tengigabytes/CANdwich/CAD/CANdwich - Enclosure.step

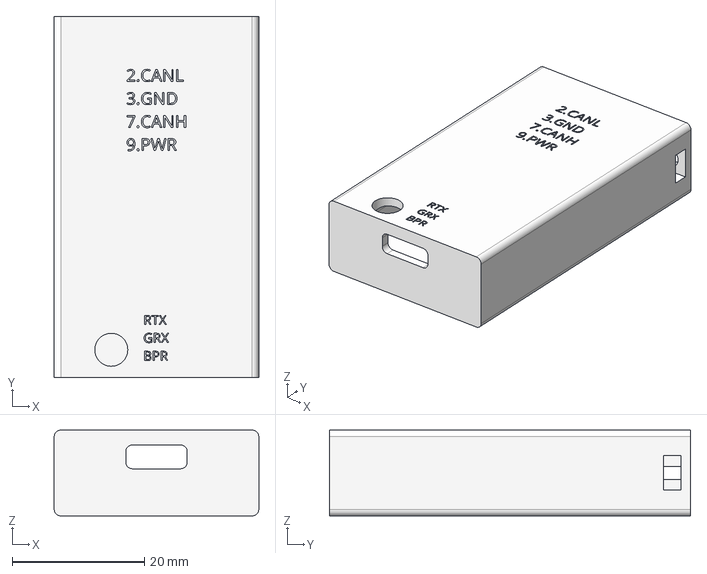
[picture p1: CAD file, 2023-06-18]
CAD/CANdwich - Enclosure.step
31.0 x 54.7 x 13.0 mm
