tengigabytes/CANdwich/CANdwich.kicad_pcb

## KiCad design CANdwich.kicad_pcb (2023-06-24)

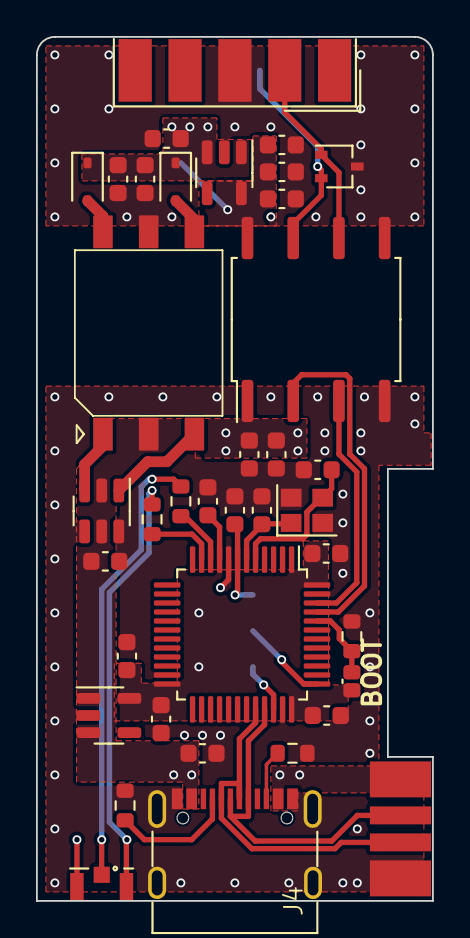
[picture p3: board CANdwich.kicad_pcb from above]

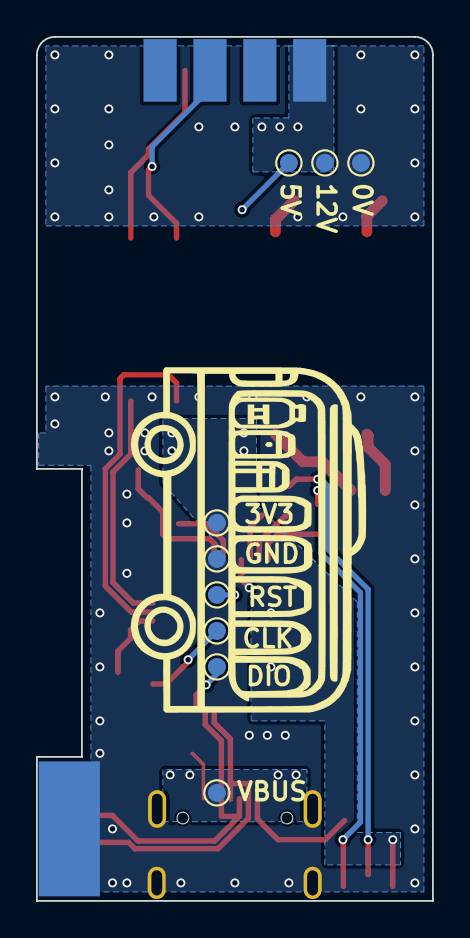
[picture p4: board CANdwich.kicad_pcb from below]

Board: 2 copper layers, 22.0 x 48.0 mm, 47 parts (9 on the bottom side), 28 nets.

Parts:
C1, C2: 8p; C_0603_1608Metric
C3, C4, C5, C6, C7, C20, C24, C25: 100n; C_0603_1608Metric
C8, C9, C22, C23, C26, C27: 1u; C_0603_1608Metric
C18, C19: 10u; C_0603_1608Metric
D1: LTST-S326KGJRKT_RG; LED_LiteOn_LTST-S326
D3, D4: NSR1020MW2T1G; D_SOD-323
D5: PESD1CAN-U; SOT-323_SC-70
J1: DE9_Receptacle; DSUB-9_Male_EdgeMount_P2.77mm
J2: USB_C_Receptacle_USB2.0; USB_C_Receptacle_XKB_U262-16XN-4BVC11
J4: Conn_01x04_Socket; USB_EdgeMount
R1: 10k; R_0603_1608Metric
R2, R3: 5.1k; R_0603_1608Metric
R4, R5, R7: 150; R_0603_1608Metric
TP1, TP2, TP3, TP4, TP5, TP6, TP7, TP8, TP9: TestPoint; TestPoint_Pad_D1.0mm
TR1: Wuerth_750316819; Transformer_Wuerth_750315371
U1: AP2127K-3.3; SOT-23-5
U2: STM32F072CBT6; LQFP-48_7x7mm_P0.5mm
U3: SN6505BDBV; SOT-23-6
U4: AP2204K-5.0TRG1; SOT-23-5
U6: ISO1050DUB; SOP-8_6.62x9.15mm_P2.54mm
Y1: 16MHz; Crystal_SMD_2520-4Pin_2.5x2.0mm

Connections:
+5VD: C23.2, C24.1, C26.2, TP4.1, U4.5 (VOUT), U6.8 (VCC2)
+12V: C19.1, C20.1, C22.2, D3.1 (K), D4.1 (K), J1.9, TP3.1, U4.1 (VIN), U4.3 (EN)
/BOOT0: R1.2, R7.1, U2.44 (BOOT0)
/CANH: D5.2 (C2), J1.7, U6.7 (CANH)
/CANL: D5.1 (C1), J1.2, U6.6 (CANL)
/CAN_RX: U2.45 (PB8), U6.2 (RXD)
/CAN_TX: U2.46 (PB9), U6.3 (TXD)
/LED_RX: R5.1, U2.11 (PA1)
/LED_TX: R4.1, U2.10 (PA0)
/SWCLK: TP6.1, U2.37 (PA14)
/SWDIO: TP5.1, U2.34 (PA13)
/USB_D+: J2.A6 (D+), J2.B6 (D+), J4.3, U2.33 (PA12)
/USB_D-: J2.A7 (D-), J2.B7 (D-), J4.2, U2.32 (PA11)
/clk_N: C2.2, U2.6 (PF1), Y1.1
/clk_P: C1.2, U2.5 (PF0), Y1.3
/nRST: C3.1, TP7.1, U2.7 (NRST)
Earth: C1.1, C2.1, C3.2, C4.1, C5.1, C6.1, C7.1, C8.1, C9.1, C18.2, C25.2, C27.1, J2.A1 (GND), J2.A12 (GND), J2.B1 (GND), J2.B12 (GND), J2.S1 (SHIELD), J4.4, R1.1, R2.2, R3.2, TP9.1, U1.2 (GND), U2.8 (VSSA), U2.23 (VSS), U2.35 (VSS), U2.47 (VSS), U3.4 (GND), U3.6 (CLK), U6.4 (GND1), Y1.2, Y1.4
GNDA: C19.2, C20.2, C22.1, C23.1, C24.2, C26.1, D5.3 (CC), J1.3, TP8.1, TR1.5, U4.2 (GND), U6.5 (GND2)
unnamed: D1.1 (K1), R5.2
unnamed: D1.2 (K2), R4.2
unnamed: D3.2 (A), TR1.4
unnamed: D4.2 (A), TR1.6
unnamed: J2.A5 (CC1), R2.1
unnamed: J2.B5 (CC2), R3.1
unnamed: TR1.3, U3.1 (D1)
unnamed: TR1.1, U3.3 (D2)
VBUS: C8.2, C18.1, J2.A4 (VBUS), J2.A9 (VBUS), J2.B4 (VBUS), J2.B9 (VBUS), J4.1, TP1.1, TR1.2, U1.1 (VIN), U1.3 (EN), U3.2 (VCC), U3.5 (EN)
VD3V3: C4.2, C5.2, C6.2, C7.2, C9.2, C25.1, C27.2, D1.3 (A), R7.2, TP2.1, U1.5 (VOUT), U2.1 (VBAT), U2.9 (VDDA), U2.24 (VDD), U2.36 (VDDIO2), U2.48 (VDD), U6.1 (VCC1)
