tengigabytes/CANdwich/(commit log)

2023-06-11 7.02 base line
    [CANdwich.kicad_pcb, CANdwich.kicad_sch]
2023-06-11 Placement in KICAD V7.0.5
    [CANdwich.kicad_pcb, CANdwich.kicad_sch]
2023-06-13 Snapshot for layout
    [CANdwich.kicad_pcb, CANdwich.kicad_sch]
2023-06-17 resize edge.cuts
    [CANdwich.kicad_pcb, CANdwich.kicad_sch]
2023-06-18 V1.0 Generate external enclosure
    [CANdwich - Enclosure.step, CANdwich.kicad_pcb, CANdwich.kicad_sch, bom.csv, designators.csv, positions.csv]
2023-06-22 Change USB edge connection interface
    [CANdwich.kicad_pcb, CANdwich.kicad_sch]
2023-06-24 Change indication LED
    [CANdwich.kicad_pcb, CANdwich.kicad_sch]
